Longan-Labs/EAGLE_CANBED_DUAL/CANBedDualGd.brd

## EAGLE design CANBedDualGd.brd (2022-07-20)

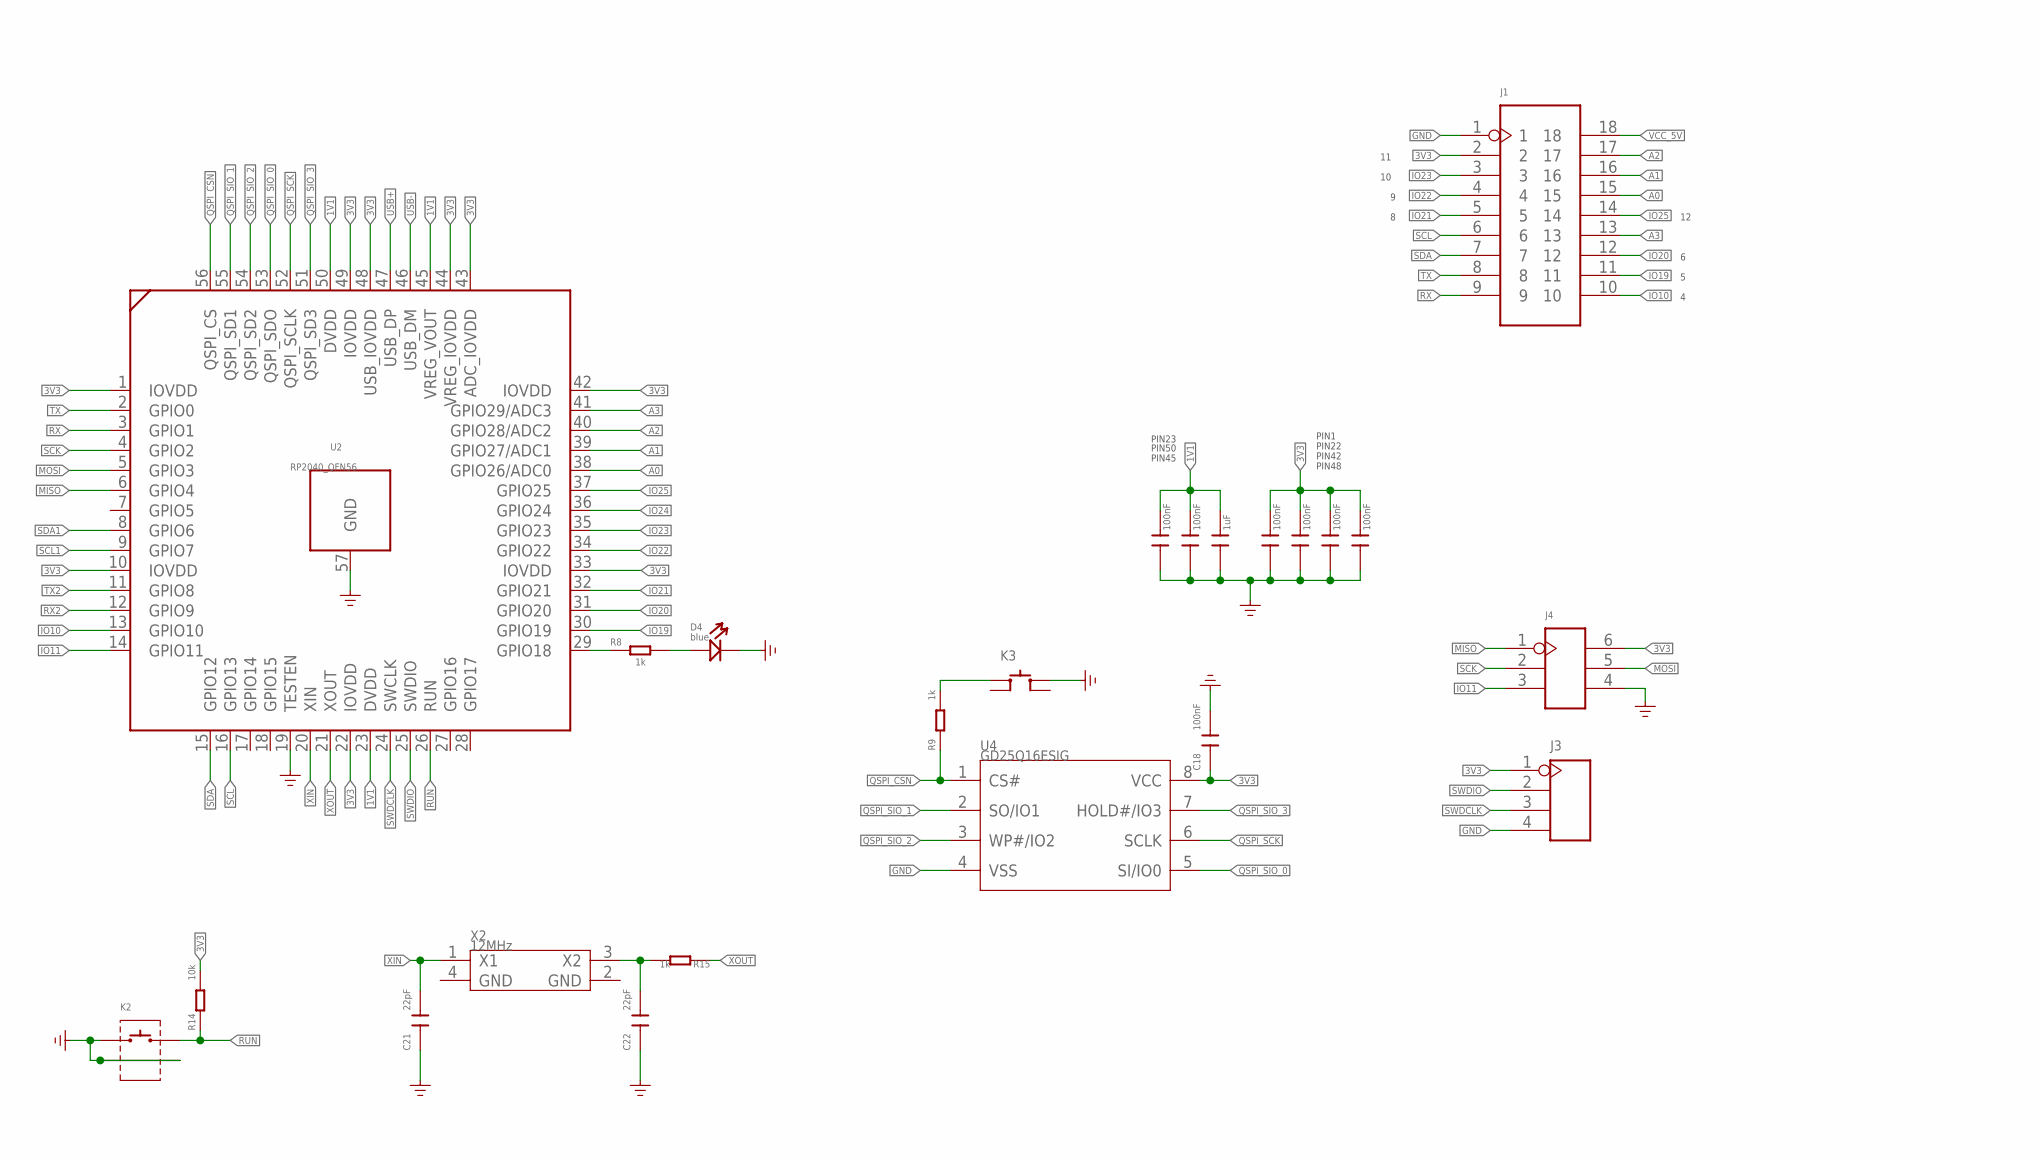
[picture p1: schematic CANBedDualGd.sch, sheet 1, part in row 1, column 1]

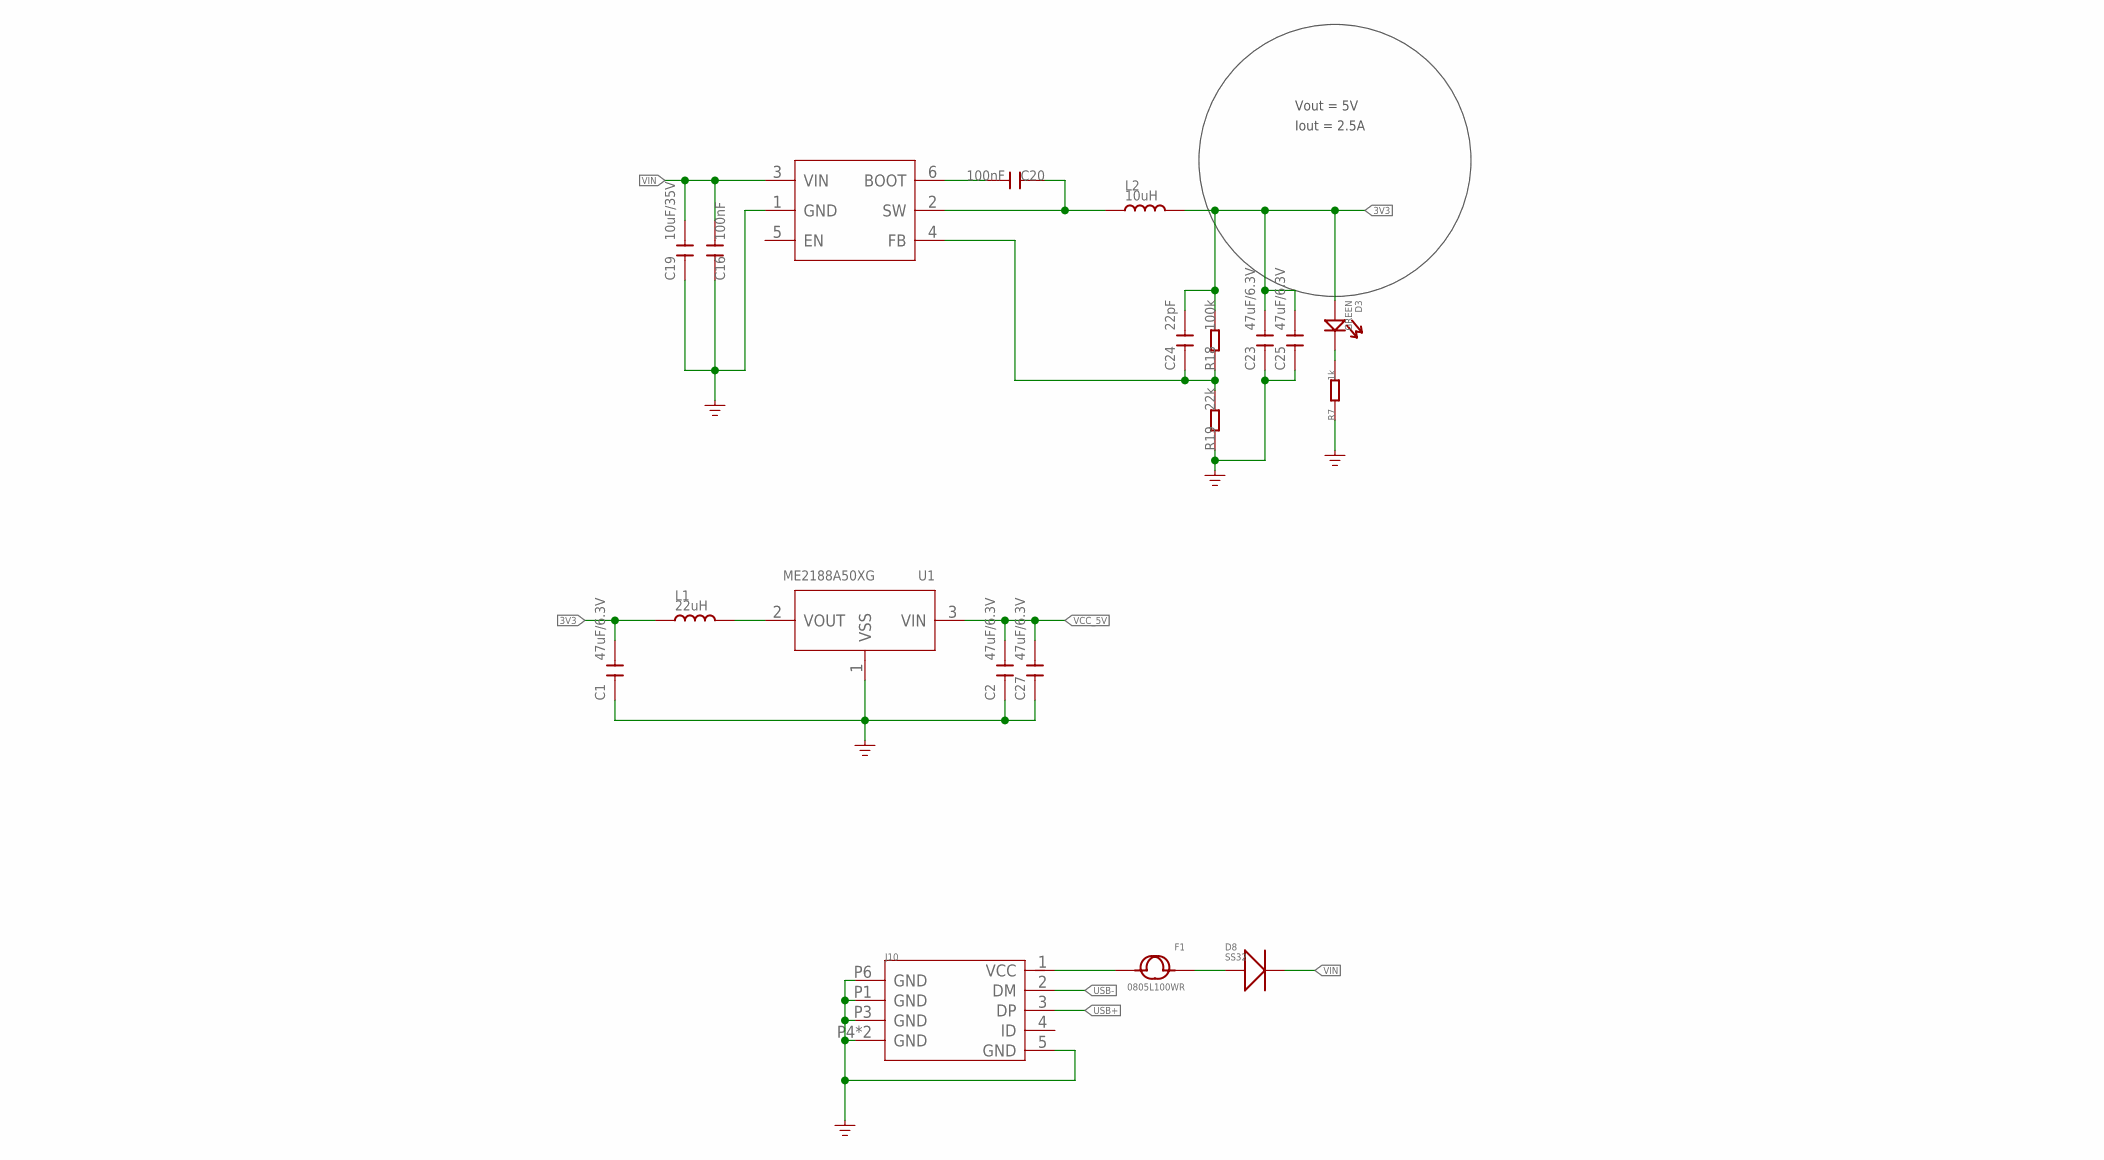
[picture p2: schematic CANBedDualGd.sch, sheet 1, part in row 1, column 2]

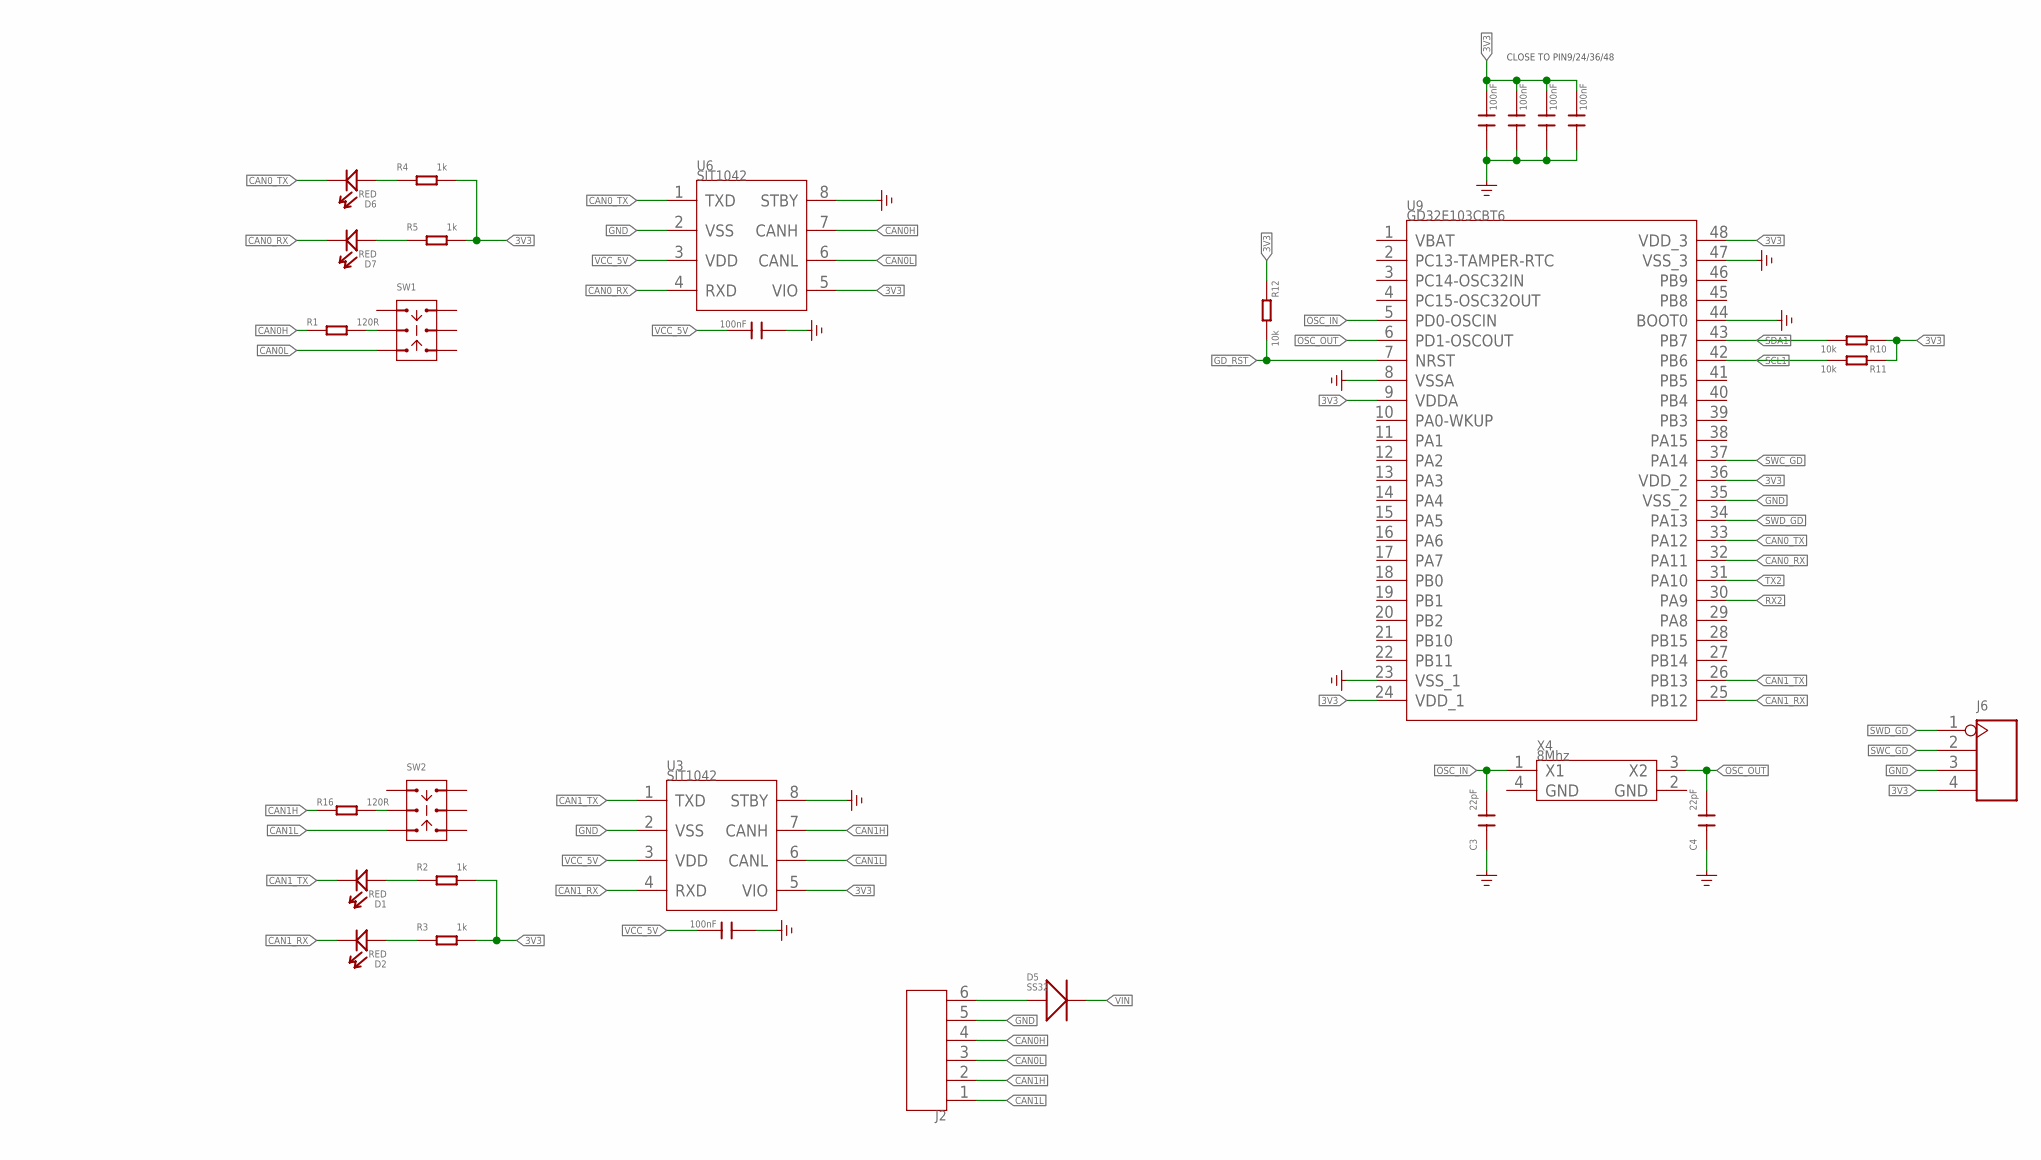
[picture p3: schematic CANBedDualGd.sch, sheet 1, part in row 1, column 3]

Parts:
C1, C2, C23, C25, C27: 47uF/6.3V; C0805
C3, C4, C21, C22, C24: 22pF; C0603
C5, C6, C7, C8, C9, C10, C12, C13, C14, C15, C16, C17, C18, C20, C26: 100nF; C0603
C11: 1uF; C0603
C19: 10uF/35V; C1206
D1, D2, D6, D7: RED; LED-0603
D3: GREEN; LED-0603
D4: blue; LED-0603
D5, D8: SS32; DO-214AC
F1: 0805L100WR; F0805
J1: HEADER-2X9P-2.54; H2X9-2.54
J2: SCREW-TERMINAL-6P-3.5; H6-3.5-21.7X7.0MM
J3, J6: HEADER-4P-SMD; H4-SMD-2.54
J4: HEADER-2X3P-2.54; H2X3-2.54
J10: MICRO-USB5+4P-320010050; MICRO-USB5+5P-SMD-0.65-7.2X5.06MM
K2: BUTTON-2+2P; SW2+2P-7.7X2.75X3.95MM
K3: BUTTON-4P-4.5X4.5X3.3MM; SW4-4.5X4.5X3.3MM
L1: 22uH; L3030-TAIYO-YUDEN-NR3012
L2: 10uH; L0420
R1, R16: 120R; R0603
R2, R3, R4, R5, R7, R8, R9, R15: 1k; R0603
R10, R11, R12, R14: 10k; R0603
R18: 100k; R0603
R19: 22k; R0603
SW1, SW2: SWITCH-2CH-6P-311010004; SW6-2.54-9.0X3.5X3.2+2.0MM
U1: ME2188A50XG; SOT-23
U2: RP2040_QFN56
U3, U6: SIT1042; SOIC8-1.27-5X4MM
U4: GD25Q16ESIG; SOP8-1.27-5.3X5.25X2MM
U5: PMIC-TPS54302; SOT-23-6
U9: GD32E103CBT6; LQFP48
X2: 12MHz; X4-SMD-3.2X2.5X0.7MM
X4: 8Mhz; X4-SMD-3.2X2.5X0.7MM

Connections:
1V1: C9.2, C10.2, C11.2, U2.23 (DVDD), U2.45 (VREG_VOUT), U2.50 (DVDD)
3V3: C1.2, C5.2, C6.2, C7.2, C8.2, C12.2, C13.2, C14.2, C15.2, C18.1, C23.2, C24.2, C25.2, D3.+, J1.2, J3.1, J4.6, J6.4, L1.1, L2.2, R2.2, R3.2, R4.2, R5.2, R10.1, R11.1, R12.1, R14.2, R18.2, U2.1 (IOVDD), U2.10 (IOVDD), U2.22 (IOVDD), U2.33 (IOVDD), U2.42 (IOVDD), U2.43 (ADC_IOVDD), U2.44 (VREG_IOVDD), U2.48 (USB_IOVDD), U2.49 (IOVDD), U3.5 (VIO), U4.8 (VCC), U6.5 (VIO), U9.9 (VDDA), U9.24 (VDD_1), U9.36 (VDD_2), U9.48 (VDD_3)
A0: J1.15, U2.38 (GPIO26/ADC0)
A1: J1.16, U2.39 (GPIO27/ADC1)
A2: J1.17, U2.40 (GPIO28/ADC2)
A3: J1.13, U2.41 (GPIO29/ADC3)
CAN0H: J2.4, R1.1, U6.7 (CANH)
CAN0L: J2.3, SW1.CH1B, U6.6 (CANL)
CAN0_RX: D7.-, U6.4 (RXD), U9.32 (PA11)
CAN0_TX: D6.-, U6.1 (TXD), U9.33 (PA12)
CAN1H: J2.2, R16.1, U3.7 (CANH)
CAN1L: J2.1, SW2.CH1B, U3.6 (CANL)
CAN1_RX: D2.-, U3.4 (RXD), U9.25 (PB12)
CAN1_TX: D1.-, U3.1 (TXD), U9.26 (PB13)
EXT_PWR: F1.2, J10.1 (VCC)
GD_RST: R12.2, U9.7 (NRST)
GND: C1.1, C2.1, C3.1, C4.1, C5.1, C6.1, C7.1, C8.1, C9.1, C10.1, C11.1, C12.1, C13.1, C14.1, C15.1, C16.1, C17.1, C18.2, C19.1, C21.1, C22.1, C23.1, C25.1, C26.1, C27.1, D4.-, J1.1, J2.5, J3.4, J4.4, J6.3, J10.5 (GND), J10.P1 (GND), J10.P3 (GND), J10.P4 (GND), J10.P5 (GND), J10.P6 (GND), K2.1, K2.S1, K2.S2, K3.3 (B0), R7.1, R19.1, U1.1 (VSS), U2.19 (TESTEN), U2.57 (GND), U3.2 (VSS), U3.8 (STBY), U4.4 (VSS), U5.1 (GND), U6.2 (VSS), U6.8 (STBY), U9.8 (VSSA), U9.23 (VSS_1), U9.35 (VSS_2), U9.44 (BOOT0), U9.47 (VSS_3)
IO10: J1.10, U2.13 (GPIO10)
IO11: J4.3, U2.14 (GPIO11)
IO19: J1.11, U2.30 (GPIO19)
IO20: J1.12, U2.31 (GPIO20)
IO21: J1.5, U2.32 (GPIO21)
IO22: J1.4, U2.34 (GPIO22)
IO23: J1.3, U2.35 (GPIO23)
IO24: U2.36 (GPIO24)
IO25: J1.14, U2.37 (GPIO25)
MISO: J4.1, U2.6 (GPIO4)
MOSI: J4.5, U2.5 (GPIO3)
unnamed: D3.-, R7.2
unnamed: D1.+, R2.1
unnamed: R8.1, U2.29 (GPIO18)
unnamed: R1.2, SW1.COM1
unnamed: R16.2, SW2.COM1
unnamed: D4.+, R8.2
unnamed: K3.1 (A0), R9.2
unnamed: C22.2, R15.2, X2.3 (X2)
unnamed: D6.+, R4.1
unnamed: D7.+, R5.1
unnamed: D8.1 (+), F1.1
unnamed: C20.1, L2.1, U5.2 (SW)
unnamed: C20.2, U5.6 (BOOT)
unnamed: D2.+, R3.1
unnamed: L1.2, U1.2 (VOUT)
unnamed: D5.1 (+), J2.6
unnamed: C24.1, R18.1, R19.2, U5.4 (FB)
OSC_IN: C3.2, U9.5 (PD0-OSCIN), X4.1 (X1)
OSC_OUT: C4.2, U9.6 (PD1-OSCOUT), X4.3 (X2)
QSPI_CSN: R9.1, U2.56 (QSPI_CS), U4.1 (CS#)
QSPI_SCK: U2.52 (QSPI_SCLK), U4.6 (SCLK)
QSPI_SIO_0: U2.53 (QSPI_SDO), U4.5 (SI/IO0)
QSPI_SIO_1: U2.55 (QSPI_SD1), U4.2 (SO/IO1)
QSPI_SIO_2: U2.54 (QSPI_SD2), U4.3 (WP#/IO2)
QSPI_SIO_3: U2.51 (QSPI_SD3), U4.7 (HOLD#/IO3)
RUN: K2.2, R14.1, U2.26 (RUN)
RX: J1.9, U2.3 (GPIO1)
RX2: U2.12 (GPIO9), U9.30 (PA9)
SCK: J4.2, U2.4 (GPIO2)
SCL: J1.6, U2.16 (GPIO13)
SCL1: R11.2, U2.9 (GPIO7), U9.42 (PB6)
SDA: J1.7, U2.15 (GPIO12)
SDA1: R10.2, U2.8 (GPIO6), U9.43 (PB7)
SWC_GD: J6.2, U9.37 (PA14)
SWDCLK: J3.3, U2.24 (SWCLK)
SWDIO: J3.2, U2.25 (SWDIO)
SWD_GD: J6.1, U9.34 (PA13)
TX: J1.8, U2.2 (GPIO0)
TX2: U2.11 (GPIO8), U9.31 (PA10)
USB+: J10.3 (DP), U2.47 (USB_DP)
USB-: J10.2 (DM), U2.46 (USB_DM)
VCC_5V: C2.2, C17.2, C26.2, C27.2, J1.18, U1.3 (VIN), U3.3 (VDD), U6.3 (VDD)
VIN: C16.2, C19.2, D5.2 (-), D8.2 (-), U5.3 (VIN)
XIN: C21.2, U2.20 (XIN), X2.1 (X1)
XOUT: R15.1, U2.21 (XOUT)

Notes on the sheet:
PIN1
PIN22
PIN42
PIN48
PIN23
PIN50
PIN45
CLOSE TO PIN9/24/36/48
Vout = 5V
Iout = 2.5A

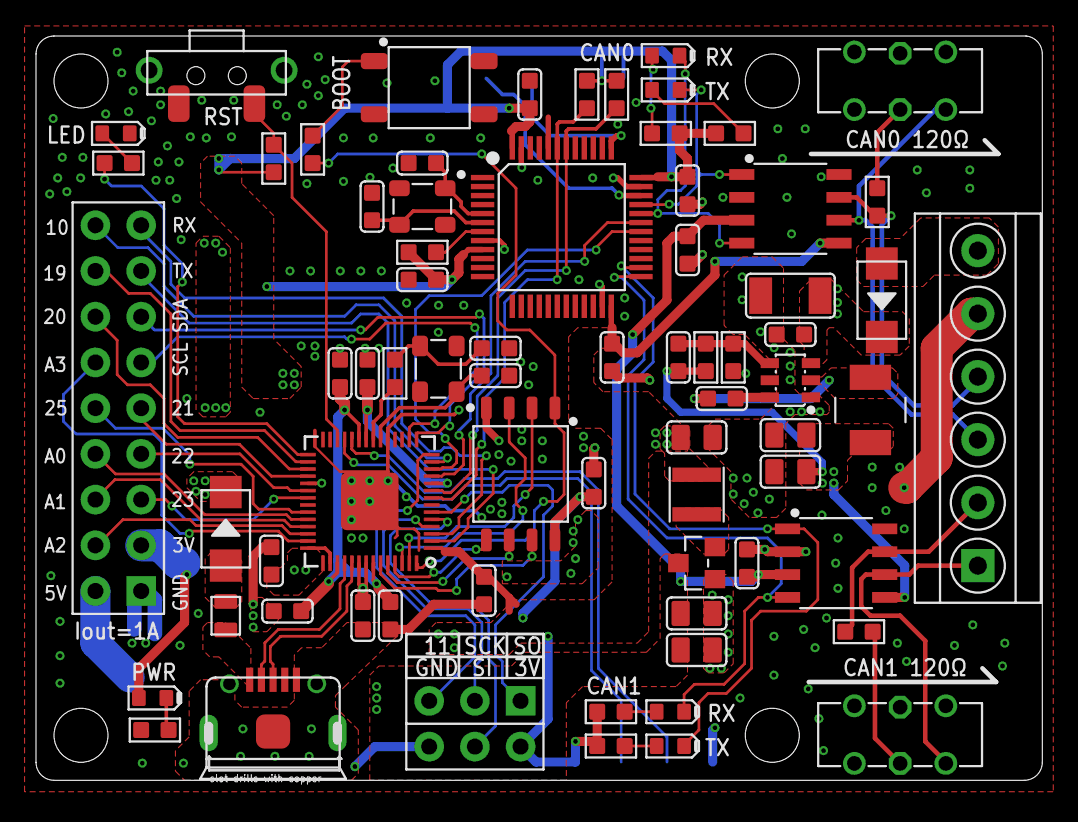
[picture p4: board CANBedDualGd.brd from above]

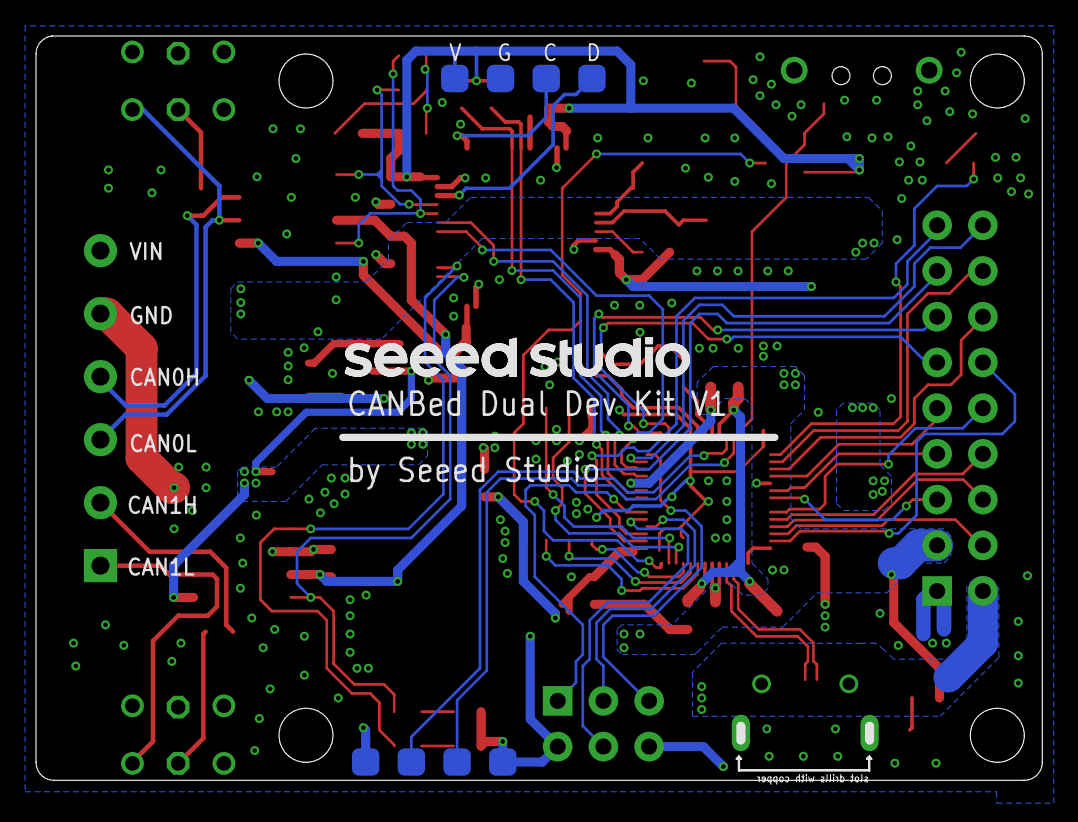
[picture p5: board CANBedDualGd.brd from below]

Board: 2 copper layers, 55.9 x 41.4 mm, 74 parts (3 on the bottom side), 72 nets.

Other parts of the board:
U$23: LOGO-SEEED-NEW-2_1X19.1MM
